pierretu/Amp-Camp-Preamp/Project Files/Capacitors.jpg

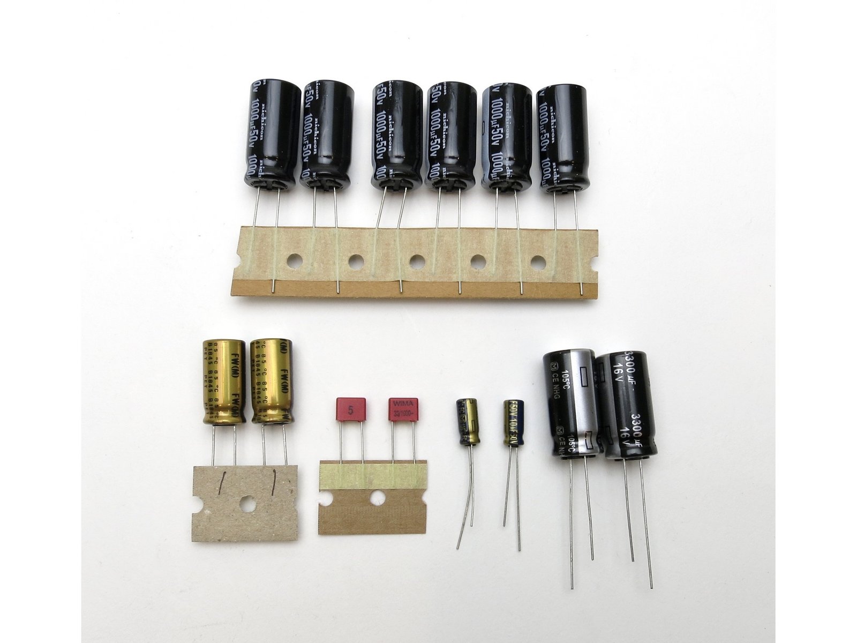
Project Files/Capacitors.jpg
