pierretu/Amp-Camp-Preamp/Project Files/PCB-Top-v1r2.jpg

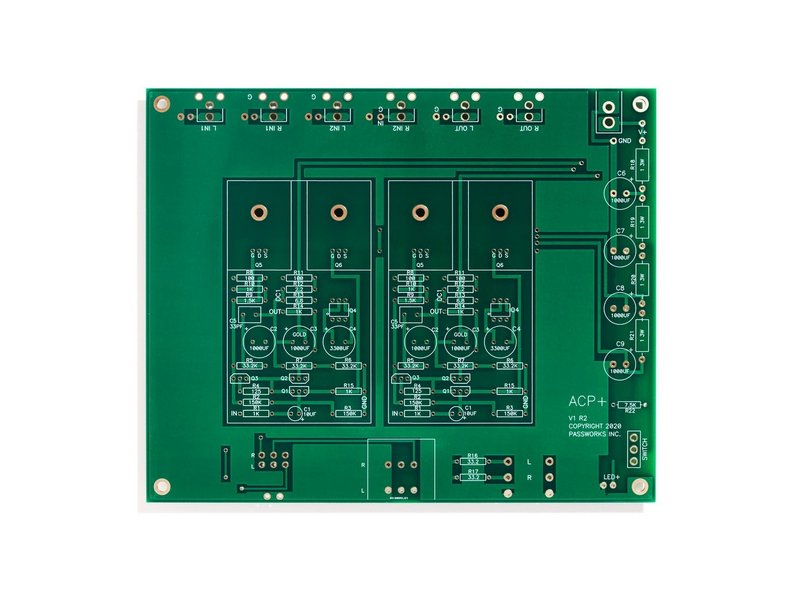
Project Files/PCB-Top-v1r2.jpg
