pierretu/Amp-Camp-Preamp/Project Files/Connectors.jpg

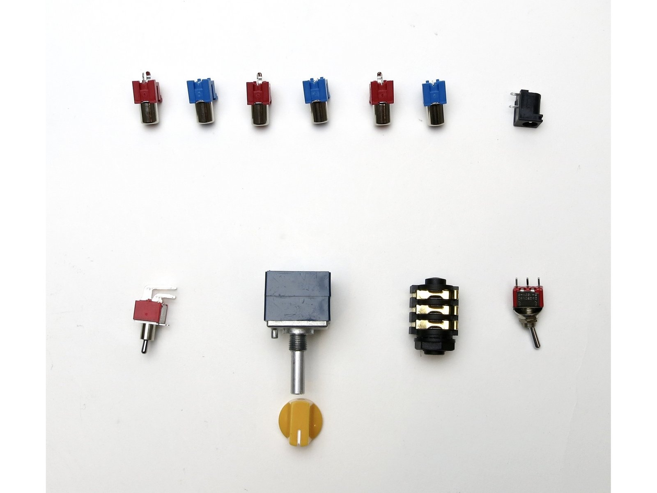
Project Files/Connectors.jpg
