pierretu/Amp-Camp-Preamp/Project Files/Powersupply.jpg

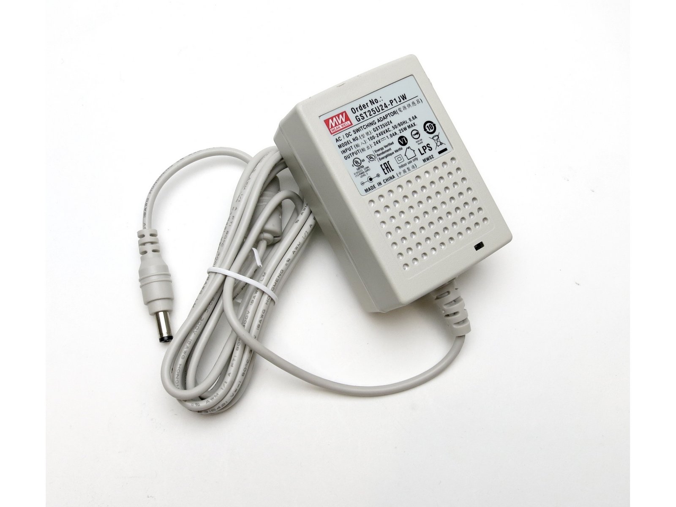
Project Files/Powersupply.jpg
