pierretu/Amp-Camp-Preamp/Project Files/Resistors.jpg

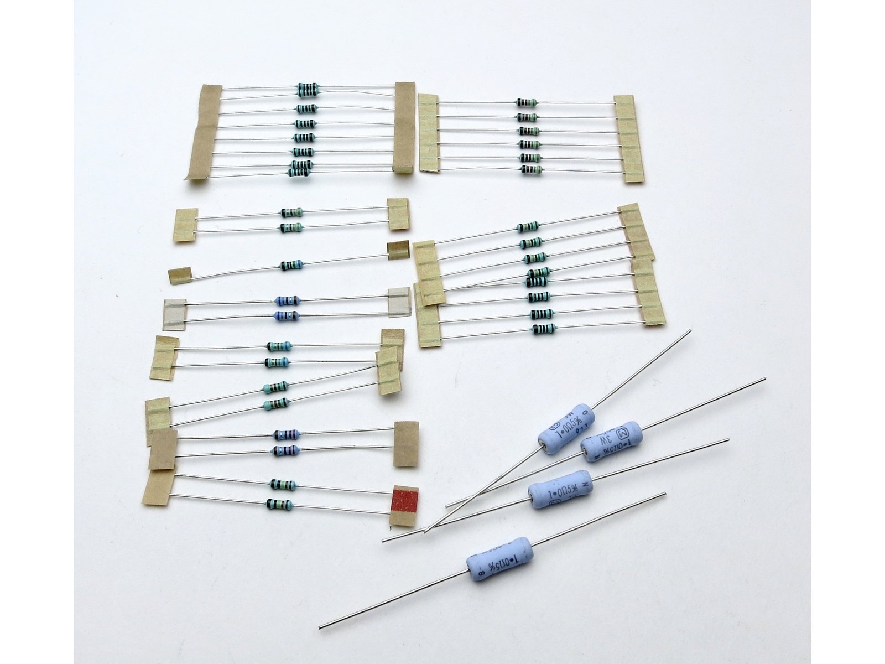
Project Files/Resistors.jpg
