pierretu/Amp-Camp-Preamp/production/bom.csv

Designator | Footprint | Quantity | Value | LCSC Part #
_4, _3, _2, |  | 4
H1, H2, H3, H4 | MountingHole_3.2mm_Pad | 4 | MountingHole_M3_3.2mm_Pad
