pierretu/Amp-Camp-Preamp/Amp Camp Preamp.kicad_pcb

## KiCad design Amp Camp Preamp.kicad_pcb (2024-12-12)

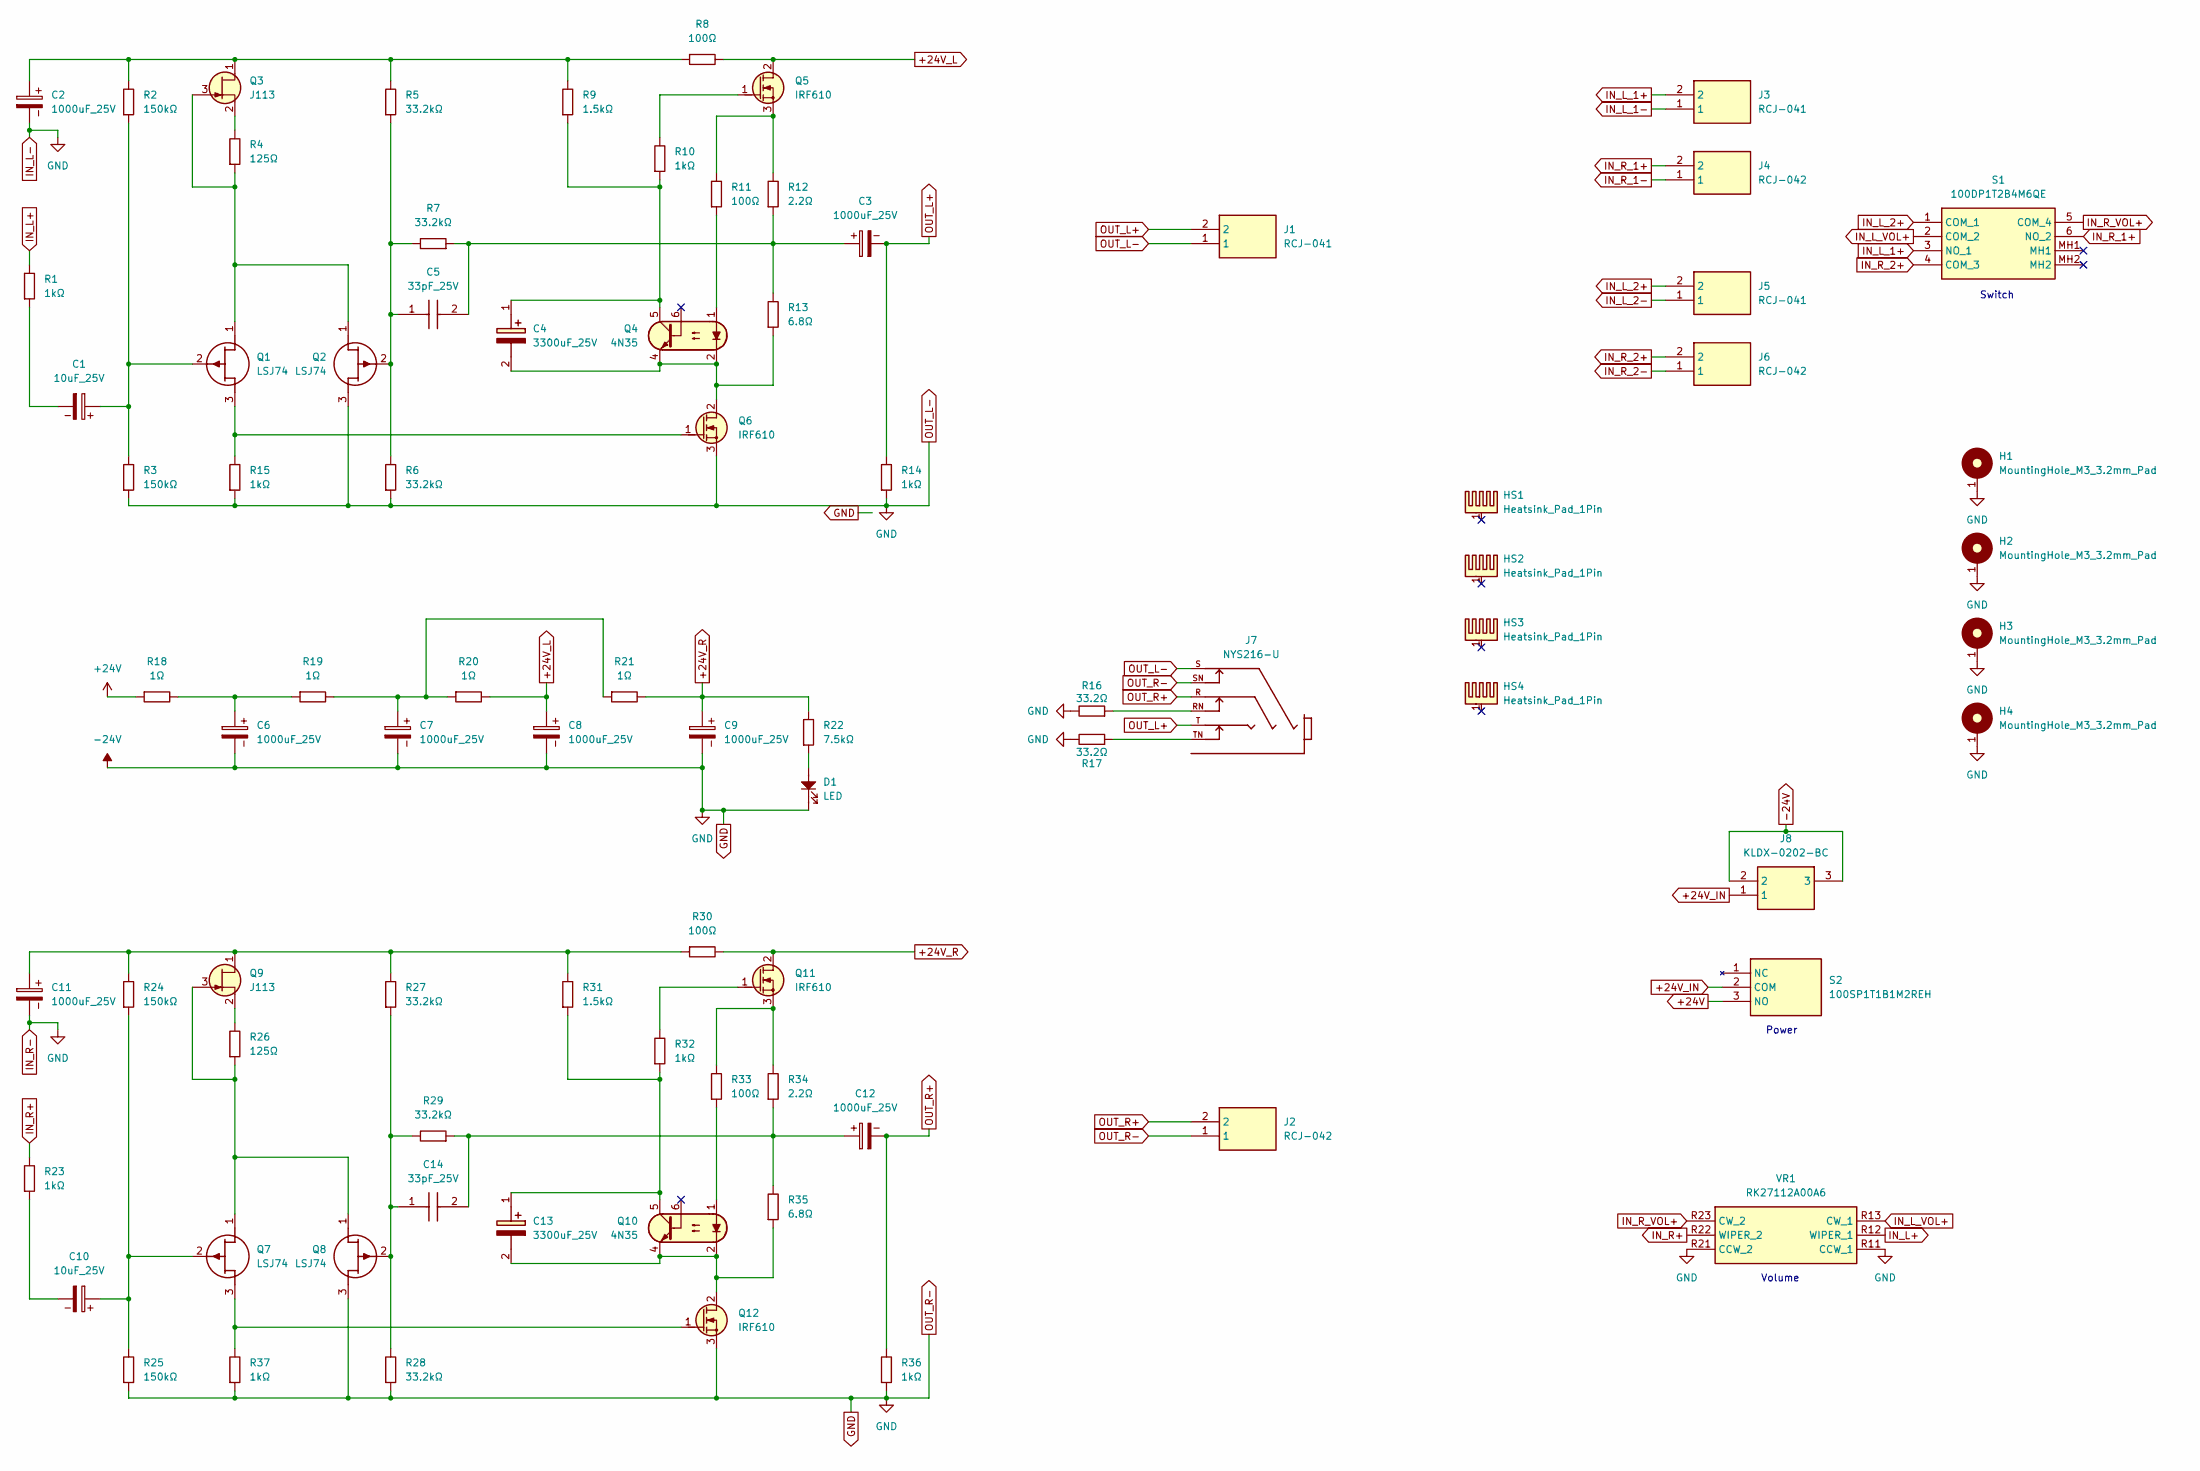
[picture p16: schematic Amp Camp Preamp.kicad_sch]

Parts:
C1, C10: 10uF_25V; CP_Radial_D5.0mm_P2.00mm
C2, C3, C6, C7, C8, C9, C11, C12: 1000uF_25V; CP_Radial_D13.0mm_P5.00mm
C4, C13: 3300uF_25V; CAPPRD750W80D1625H2700; Manufacturer_Part_Number UFW1E332MHD1TN
C5, C14: 33pF_25V; FKP2O100331D00JSSD; Manufacturer_Part_Number FKP2O100331D00JSSD
D1: LED; LED_D5.0mm
H1, H2, H3, H4: MountingHole_M3_3.2mm_Pad; MountingHole_3.2mm_Pad
HS1, HS2, HS3, HS4: Heatsink_Pad_1Pin; Heatsink_36.83x25.55mm_1xFixation3mm_Digikey_HS193-ND
J1, J3, J5: RCJ-041; RCJ041; Manufacturer_Part_Number RCJ-041
J2, J4, J6: RCJ-042; RCJ041; Manufacturer_Part_Number RCJ-042
J7: NYS216-U; NYS216-U_REAN_NYS216-U; PARTREV 2015.05.27
J8: KLDX-0202-BC; KLDX0202BC; Manufacturer_Part_Number KLDX-0202-BC
Q1, Q2, Q7, Q8: LSJ74; TO-92_Inline_Wide_DSG; Manufacturer_Part_Number LSJ74
Q3, Q9: J113; TO-92_Inline_Wide_DSG
Q4, Q10: 4N35; DIP-6_W7.62mm_LongPads
Q5, Q6, Q11, Q12: IRF610; TO-220-3_Vertical_GDS
R1, R10, R14, R15, R23, R32, R36, R37: 1kΩ; R_Axial_DIN0207_L6.3mm_D2.5mm_P10.16mm_Horizontal
R2, R3, R24, R25: 150kΩ; R_Axial_DIN0207_L6.3mm_D2.5mm_P10.16mm_Horizontal
R4, R26: 125Ω; R_Axial_DIN0207_L6.3mm_D2.5mm_P10.16mm_Horizontal
R5, R6, R7, R27, R28, R29: 33.2kΩ; R_Axial_DIN0207_L6.3mm_D2.5mm_P10.16mm_Horizontal
R8, R11, R30, R33: 100Ω; R_Axial_DIN0207_L6.3mm_D2.5mm_P10.16mm_Horizontal
R9, R31: 1.5kΩ; R_Axial_DIN0207_L6.3mm_D2.5mm_P10.16mm_Horizontal
R12, R34: 2.2Ω; R_Axial_DIN0207_L6.3mm_D2.5mm_P10.16mm_Horizontal
R13, R35: 6.8Ω; R_Axial_DIN0207_L6.3mm_D2.5mm_P10.16mm_Horizontal
R16, R17: 33.2Ω; R_Axial_DIN0207_L6.3mm_D2.5mm_P10.16mm_Horizontal
R18, R19, R20, R21: 1Ω; R_Axial_DIN0207_L6.3mm_D2.5mm_P10.16mm_Horizontal
R22: 7.5kΩ; R_Axial_DIN0207_L6.3mm_D2.5mm_P10.16mm_Horizontal
S1: 100DP1T2B4M6QE; Manufacturer_Part_Number 100DP1T2B4M6QE
S2: 100SP1T1B1M2REH; Manufacturer_Part_Number 100SP1T1B1M2REH
VR1: RK27112A00A6; Manufacturer_Part_Number RK27112A00A6

Connections:
+24V: R18.1, S2.3 (NO)
+24V_IN: J8.1, S2.2 (COM)
+24V_L: C8.1, Q5.2 (D), R8.2, R20.2
+24V_R: C9.1, Q11.2 (D), R21.2, R22.2, R30.2
-24V: C2.2, C6.2, C7.2, C8.2, C9.2, C11.2, D1.1, H1.1, H2.1, H3.1, H4.1, J1.1, J2.1, J7.S, J7.SN, J8.2, J8.3, Q2.3 (S), Q6.3 (S), Q8.3 (S), Q12.3 (S), R3.1, R6.1, R14.1, R15.1, R16.2, R17.2, R25.1, R28.1, R36.1, R37.1, VR1.R11 (CCW_1), VR1.R21 (CCW_2)
IN_L+: R1.2, VR1.R12 (WIPER_1)
IN_L_1+: J3.2, S1.3 (NO_1)
IN_L_1-: J3.1
IN_L_2+: J5.2, S1.1 (COM_1)
IN_L_2-: J5.1
IN_L_VOL+: S1.2 (COM_2), VR1.R13 (CW_1)
IN_R+: R23.2, VR1.R22 (WIPER_2)
IN_R_1+: J4.2, S1.6 (NO_2)
IN_R_1-: J4.1
IN_R_2+: J6.2, S1.4 (COM_3)
IN_R_2-: J6.1
IN_R_VOL+: S1.5 (COM_4), VR1.R23 (CW_2)
unnamed: C1.2, R1.1
unnamed: C3.1, C5.2, R7.1, R12.1, R13.2
unnamed: C4.1 (+), Q4.5, R9.1, R10.1
unnamed: C4.2 (-), Q4.2, Q4.4, Q6.2 (D), R13.1
unnamed: C6.1, R18.2, R19.1
unnamed: C7.1, R19.2, R20.1, R21.1
unnamed: C10.2, R23.1
unnamed: C12.1, C14.2, R29.1, R34.1, R35.2
unnamed: C13.1 (+), Q10.5, R31.1, R32.1
unnamed: C13.2 (-), Q10.2, Q10.4, Q12.2 (D), R35.1
unnamed: D1.2, R22.1
unnamed: J7.RN, R16.1
unnamed: J7.TN, R17.1
unnamed: Q1.1 (D), Q2.1 (D), Q3.3 (G), R4.1
unnamed: C1.1, Q1.2 (G), R2.1, R3.2
unnamed: Q1.3 (S), Q6.1 (G), R15.2
unnamed: C5.1, Q2.2 (G), R5.1, R6.2, R7.2
unnamed: C2.1, Q3.1 (D), R2.2, R5.2, R8.1, R9.2
unnamed: Q3.2 (S), R4.2
unnamed: Q4.1, R11.1
unnamed: Q5.1 (G), R10.2
unnamed: Q5.3 (S), R11.2, R12.2
unnamed: Q7.1 (D), Q8.1 (D), Q9.3 (G), R26.1
unnamed: C10.1, Q7.2 (G), R24.1, R25.2
unnamed: C14.1, Q8.2 (G), R27.1, R28.2, R29.2
unnamed: C11.1, Q9.1 (D), R24.2, R27.2, R30.1, R31.2
unnamed: Q9.2 (S), R26.2
unnamed: Q10.1, R33.1
unnamed: Q11.1 (G), R32.2
unnamed: Q11.3 (S), R33.2, R34.2
unnamed: Q7.3 (S), Q12.1 (G), R37.2
OUT_L+: C3.2, J1.2, J7.T, R14.2
OUT_R+: C12.2, J2.2, J7.R, R36.2

Notes on the sheet:
Power
Switch
Volume

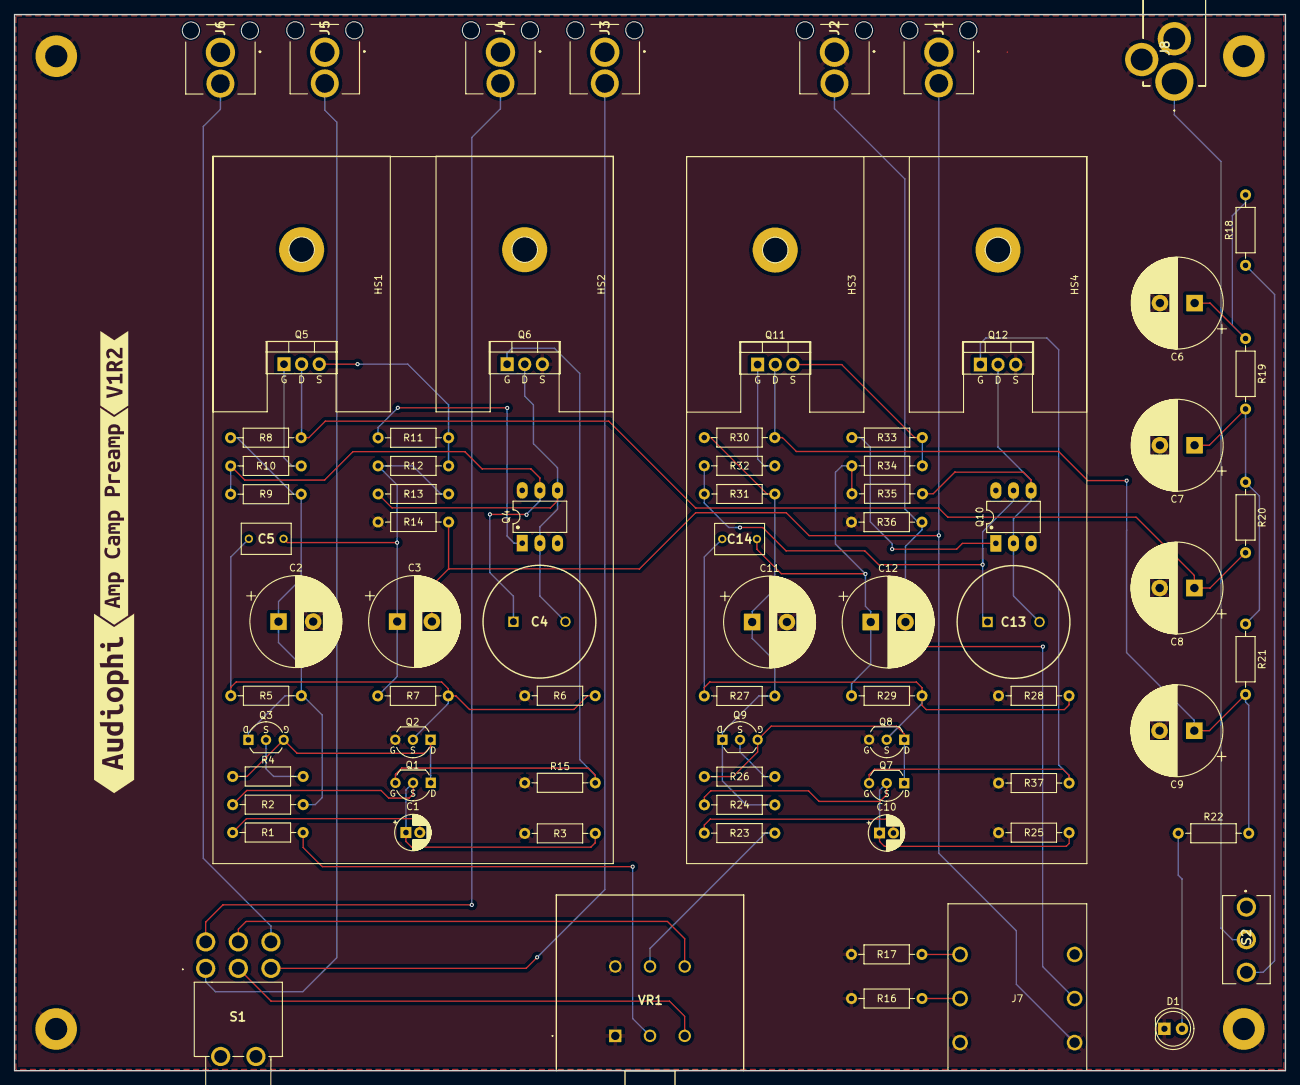
[picture p17: board Amp Camp Preamp.kicad_pcb from above]

Board: 2 copper layers, 183.1 x 152.2 mm, 86 parts (0 on the bottom side), 46 nets.

Other parts of the board:
kibuzzard-675403C8: G***; kibuzzard-675403C8
kibuzzard-6754036E: G***; kibuzzard-6754036E
kibuzzard-6754048D: G***; kibuzzard-6754048D
